kpzip/Stepper-Music/README.md

# Stepper-Music
Music with Stepper Motors!
