kpzip/Stepper-Music/models/axle_pointer/axle_pointer.FCStd

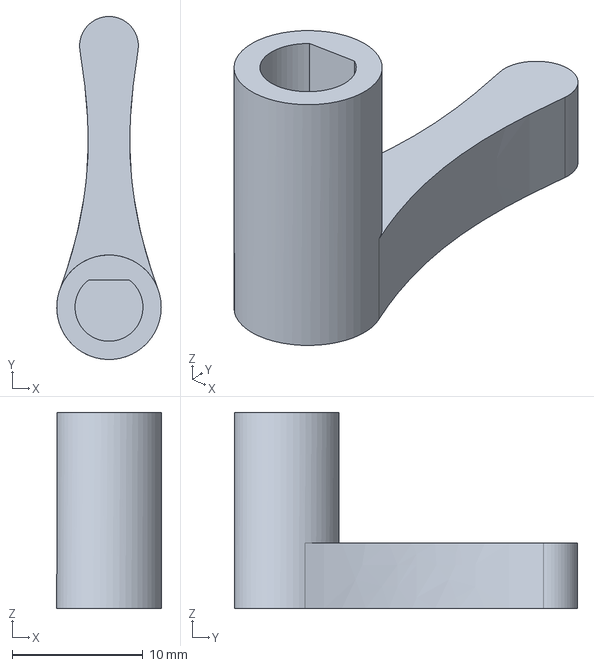
[picture p1: CAD file, 2026-04-19]
models/axle_pointer/axle_pointer.FCStd
8.00 x 26.2 x 15.0 mm
