kpzip/Stepper-Music/models/simple_4_stepper_enclosure/simple_4_stepper_enclosure.FCStd

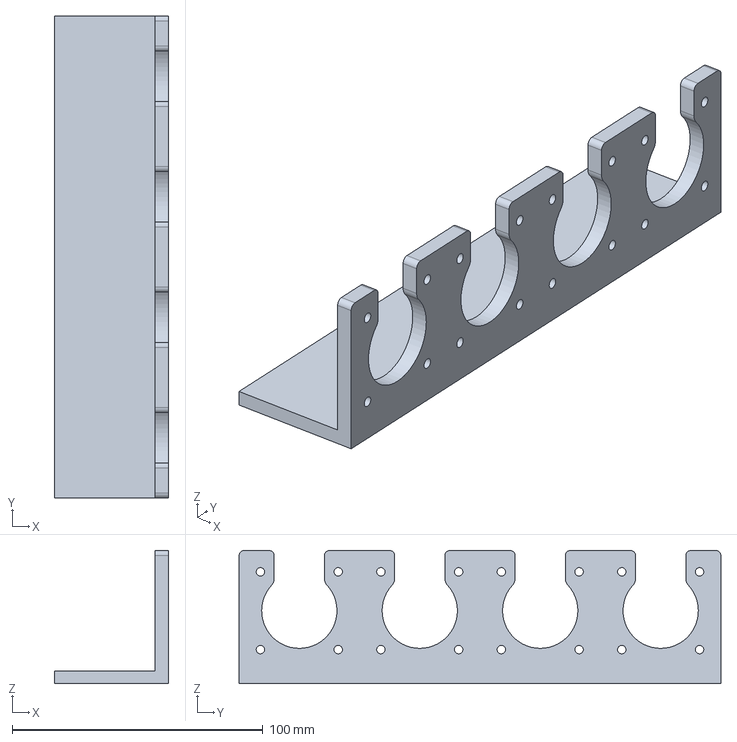
[picture p2: CAD file, 2026-04-19]
models/simple_4_stepper_enclosure/simple_4_stepper_enclosure.FCStd
45.5 x 192.0 x 53.0 mm
