kpzip/Stepper-Music/pcb/1.0/stepper_music.kicad_pcb

## KiCad design pcb/1.0/stepper_music.kicad_pcb (2026-04-06)

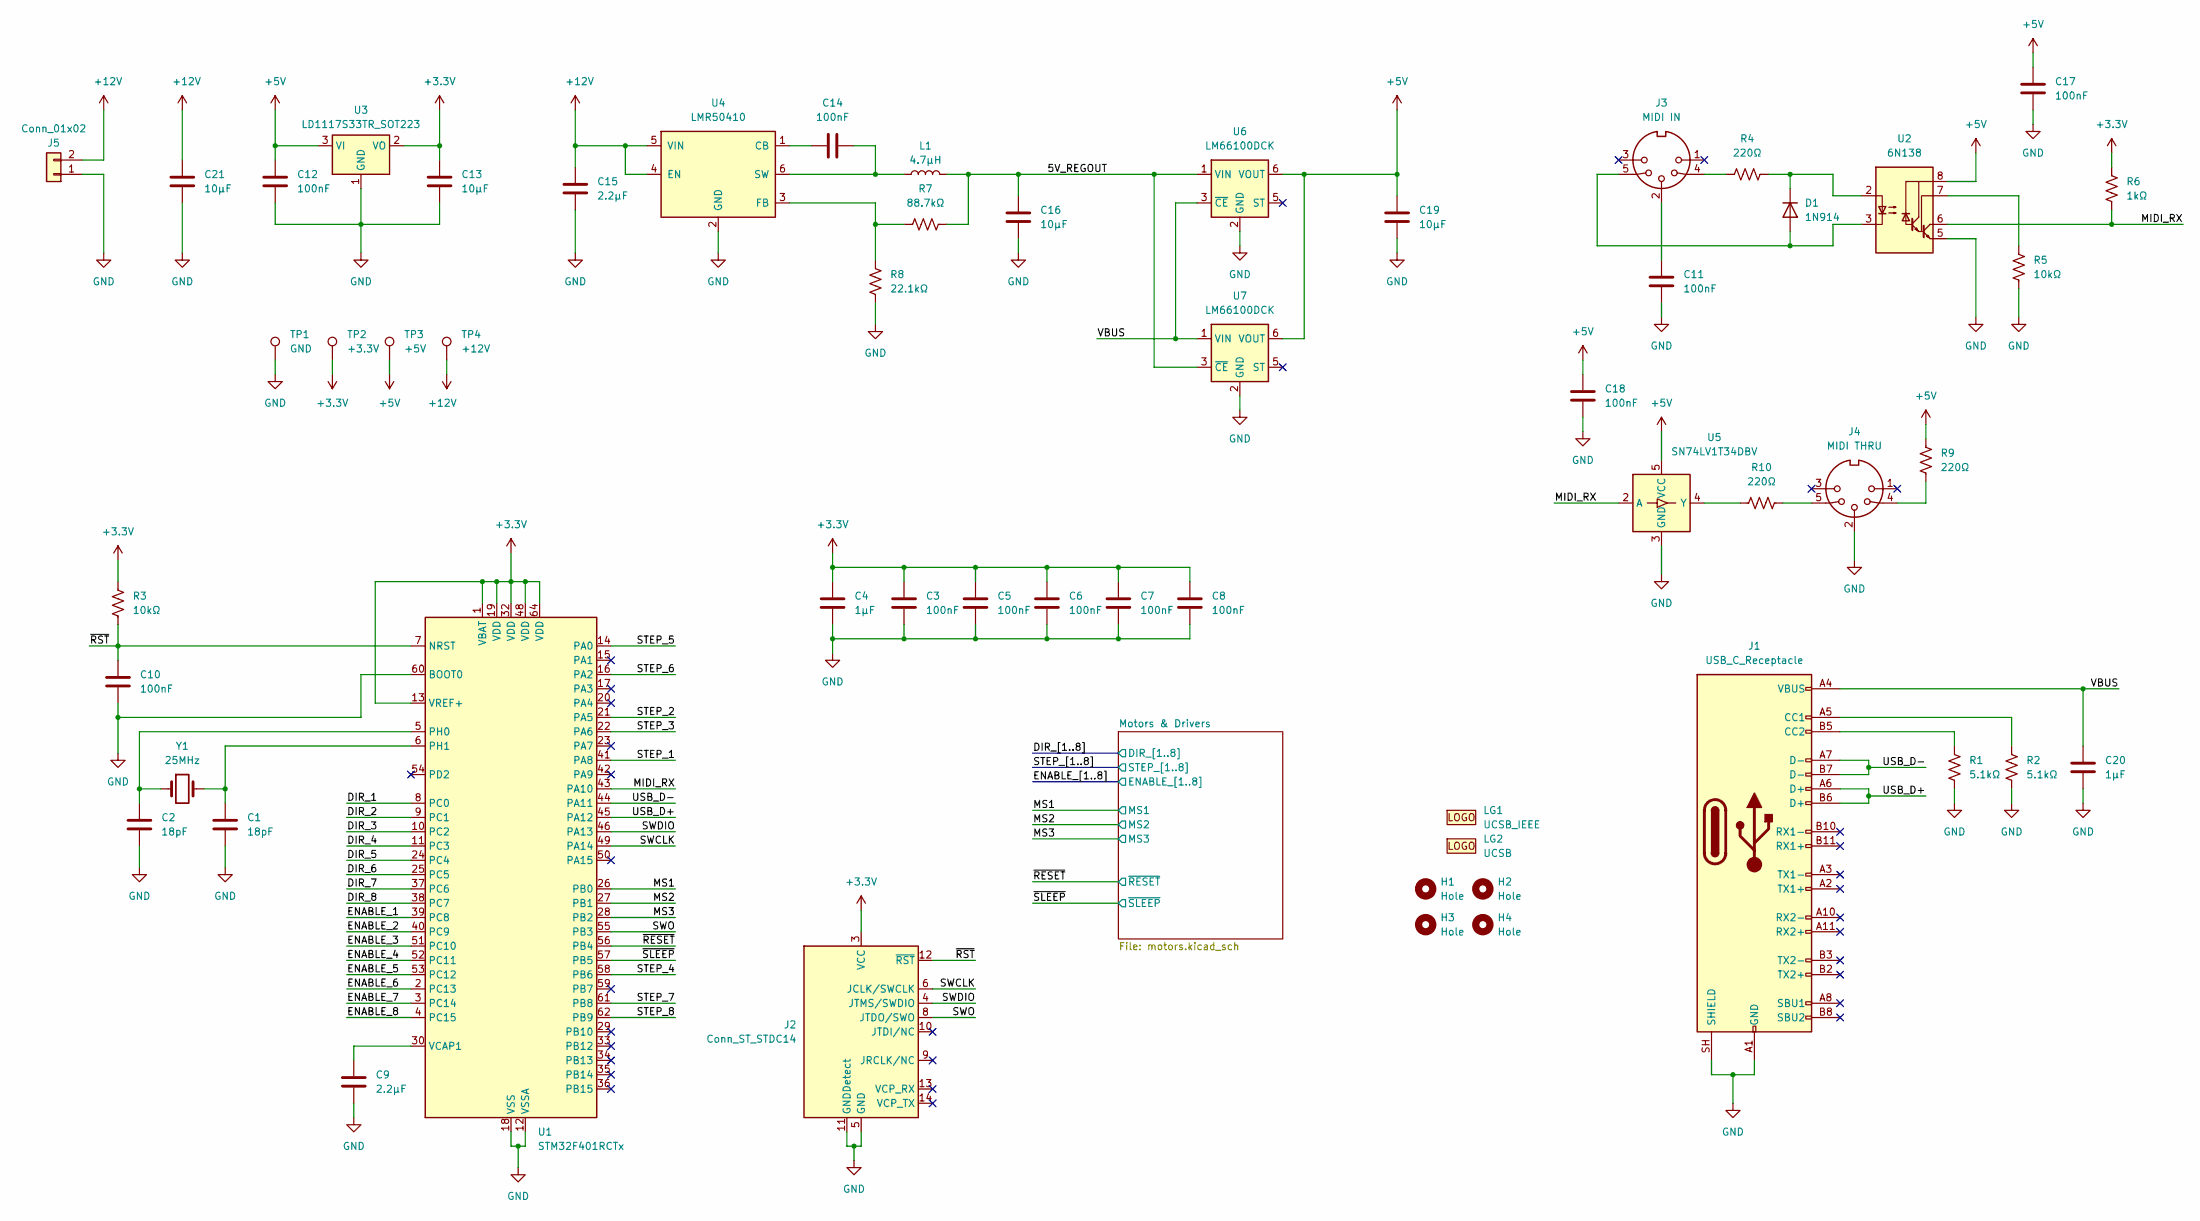
[picture p3: schematic stepper_music.kicad_sch]

Parts:
C1, C2: 18pF; C_0402_1005Metric; Manufacturer Part Number GJM1555C1H180GB01D
C3, C5, C6, C7, C8, C10, C11, C12, C14, C17, C18: 100nF; C_1206_3216Metric_Pad1.33x1.80mm_HandSolder; Manufacturer Part Number 1206B104K500CT
C4, C20: 1μF; C_1206_3216Metric_Pad1.33x1.80mm_HandSolder; Manufacturer Part Number CL31B105KAHNNNE
C9, C15: 2.2μF; C_1206_3216Metric_Pad1.33x1.80mm_HandSolder; Manufacturer Part Number UMK316BJ225KD-T
C13, C16, C19, C21: 10μF; C_1206_3216Metric_Pad1.33x1.80mm_HandSolder; Manufacturer Part Number 1276-1181-1-ND
D1: 1N914; D_SOD-523; Manufacturer Part Number 1N914BWT
H1, H2, H3, H4: Hole; MountingHole_3.2mm_M3_DIN965
J1: USB_C_Receptacle; USB_C_Receptacle_short; Manufacturer Part Number USB4056-03-A
J2: Conn_ST_STDC14; PinHeader_2x07_P1.27mm_Vertical_SMD; Manufacturer Part Number FTSH-107-01-L-DV-K
J3: MIDI IN; KYCON_KCDX-5S-N; Manufacturer Part Number KCDX-5S-N
J4: MIDI THRU; KYCON_KCDX-5S-N; Manufacturer Part Number KCDX-5S-N
J5: Conn_01x02; AMASS_XT60PW-M_1x02_P7.20mm_Horizontal; Manufacturer Part Number XT60PW-M30
L1: 4.7μH; L_1008_2520Metric_Pad1.43x2.20mm_HandSolder; Manufacturer Part Number DFE252012P-4R7M=P2
LG1: UCSB_IEEE; UCSB_IEEE_Logo
LG2: UCSB; UCSB_Medium
R1, R2: 5.1kΩ; R_1206_3216Metric_Pad1.30x1.75mm_HandSolder; Manufacturer Part Number RC1206FR-075K1L
R3, R5: 10kΩ; R_1206_3216Metric_Pad1.30x1.75mm_HandSolder; Manufacturer Part Number RMCF1206FT10K0
R4, R9, R10: 220Ω; R_1206_3216Metric_Pad1.30x1.75mm_HandSolder; Manufacturer Part Number RMCF1206FT220R
R6: 1kΩ; R_1206_3216Metric_Pad1.30x1.75mm_HandSolder; Manufacturer Part Number RC1206FR-071KL
R7: 88.7kΩ; R_1206_3216Metric_Pad1.30x1.75mm_HandSolder; Manufacturer Part Number RC1206FR-0788K7L
R8: 22.1kΩ; R_1206_3216Metric_Pad1.30x1.75mm_HandSolder; Manufacturer Part Number CRCW120622K1FKEAC
TP1: GND; TestPoint_Pad_D1.5mm
TP2: +3.3V; TestPoint_Pad_D1.5mm
TP3: +5V; TestPoint_Pad_D1.5mm
TP4: +12V; TestPoint_Pad_D1.5mm
U1: STM32F401RCTx; LQFP-64_10x10mm_P0.5mm; Manufacturer Part Number STM32F401RCT6
U2: 6N138; SOIC-8_3.9x4.9mm_P1.27mm; Manufacturer Part Number HCPL-0701
U3: LD1117S33TR_SOT223; SOT-223-3_TabPin2; Manufacturer Part Number LD1117S33TR
U4: LMR50410; SOT-23-6; Manufacturer Part Number 296-LMR50410Y5FQDBVRQ1CT-ND
U5: SN74LV1T34DBV; SOT-23-5; Manufacturer Part Number SN74LV1T34DBVR
U6, U7: LM66100DCK; SOT-363_SC-70-6; Manufacturer Part Number LM66100DCKR
Y1: 25MHz; Crystal_SMD_HC49-SD; Manufacturer Part Number ECS-250-18-5PX-F-TR

Connections:
+3.3V: C3.1, C4.1, C5.1, C6.1, C7.1, C8.1, C13.1, J2.3 (VCC), R3.1, R6.1, TP2.1 (1_1), U1.1 (VBAT), U1.13 (VREF+), U1.19 (VDD), U1.32 (VDD), U1.48 (VDD), U1.64 (VDD), U3.2 (VO); also elsewhere on the board
+5V: C12.1, C17.1, C18.1, C19.1, R9.2, TP3.1 (1_1), U2.8 (VCC), U3.3 (VI), U5.5 (VCC), U6.6 (VOUT), U7.6 (VOUT)
+12V: C15.1, C21.1, J5.2, TP4.1 (1_1), U4.4 (EN), U4.5 (VIN); also elsewhere on the board
/5V_REGOUT: C16.1, L1.2, R7.2, U6.1 (VIN), U7.3 (~CE)
/DIR_1: U1.8 (PC0); also elsewhere on the board
/DIR_2: U1.9 (PC1); also elsewhere on the board
/DIR_3: U1.10 (PC2); also elsewhere on the board
/DIR_4: U1.11 (PC3); also elsewhere on the board
/DIR_5: U1.24 (PC4); also elsewhere on the board
/DIR_6: U1.25 (PC5); also elsewhere on the board
/DIR_7: U1.37 (PC6); also elsewhere on the board
/DIR_8: U1.38 (PC7); also elsewhere on the board
/ENABLE_1: U1.39 (PC8); also elsewhere on the board
/ENABLE_2: U1.40 (PC9); also elsewhere on the board
/ENABLE_3: U1.51 (PC10); also elsewhere on the board
/ENABLE_4: U1.52 (PC11); also elsewhere on the board
/ENABLE_5: U1.53 (PC12); also elsewhere on the board
/ENABLE_6: U1.2 (PC13); also elsewhere on the board
/ENABLE_7: U1.3 (PC14); also elsewhere on the board
/ENABLE_8: U1.4 (PC15); also elsewhere on the board
/MIDI_RX: R6.2, U1.43 (PA10), U2.6 (VO2), U5.2 (A)
/MS1: U1.26 (PB0); also elsewhere on the board
/MS2: U1.27 (PB1); also elsewhere on the board
/MS3: U1.28 (PB2); also elsewhere on the board
/STEP_1: U1.41 (PA8); also elsewhere on the board
/STEP_2: U1.21 (PA5); also elsewhere on the board
/STEP_3: U1.22 (PA6); also elsewhere on the board
/STEP_4: U1.58 (PB6); also elsewhere on the board
/STEP_5: U1.14 (PA0); also elsewhere on the board
/STEP_6: U1.16 (PA2); also elsewhere on the board
/STEP_7: U1.61 (PB8); also elsewhere on the board
/STEP_8: U1.62 (PB9); also elsewhere on the board
/SWCLK: J2.6 (JCLK/SWCLK), U1.49 (PA14)
/SWDIO: J2.4 (JTMS/SWDIO), U1.46 (PA13)
/SWO: J2.8 (JTDO/SWO), U1.55 (PB3)
/USB_D+: J1.A6 (D+), J1.B6 (D+), U1.45 (PA12)
/USB_D-: J1.A7 (D-), J1.B7 (D-), U1.44 (PA11)
/VBUS: C20.1, J1.A4 (VBUS), J1.A9 (VBUS), J1.B4 (VBUS), J1.B9 (VBUS), U6.3 (~CE), U7.1 (VIN)
/~RESET: U1.56 (PB4); also elsewhere on the board
/~RST: C10.1, J2.12 (~RST), R3.2, U1.7 (NRST)
/~SLEEP: U1.57 (PB5); also elsewhere on the board
GND: C1.2, C2.2, C3.2, C4.2, C5.2, C6.2, C7.2, C8.2, C9.2, C10.2, C11.2, C12.2, C13.2, C15.2, C16.2, C17.2, C18.2, C19.2, C20.2, C21.2, J1.A1 (GND), J1.A12 (GND), J1.B1 (GND), J1.B12 (GND), J1.SH (SHIELD), J2.5 (GND), J2.7 (GND), J2.11 (GNDDetect), J4.2, J5.1, R1.2, R2.2, R5.2, R8.2, TP1.1 (1_1), U1.12 (VSSA), U1.18 (VSS), U1.31 (VSS), U1.47 (VSS), U1.60 (BOOT0), U1.63 (VSS), U2.5 (GND), U3.1 (GND), U4.2 (GND), U5.3 (GND), U6.2 (GND), U7.2 (GND); also elsewhere on the board
unnamed: C11.1, J3.2
unnamed: D1.2 (A), J3.5, U2.3 (C2)
unnamed: D1.1 (K), R4.2, U2.2 (C1)
unnamed: J1.A5 (CC1), R2.1
unnamed: J1.B5 (CC2), R1.1
unnamed: J3.4, R4.1
unnamed: J4.4, R9.1
unnamed: J4.5, R10.1
unnamed: C2.1, U1.5 (PH0), Y1.1
unnamed: C1.1, U1.6 (PH1), Y1.2
unnamed: C9.1, U1.30 (VCAP1)
unnamed: R5.1, U2.7 (VO1)
unnamed: C14.1, U4.1 (CB)
unnamed: R7.1, R8.1, U4.3 (FB)
unnamed: C14.2, L1.1, U4.6 (SW)
unnamed: R10.2, U5.4 (Y)

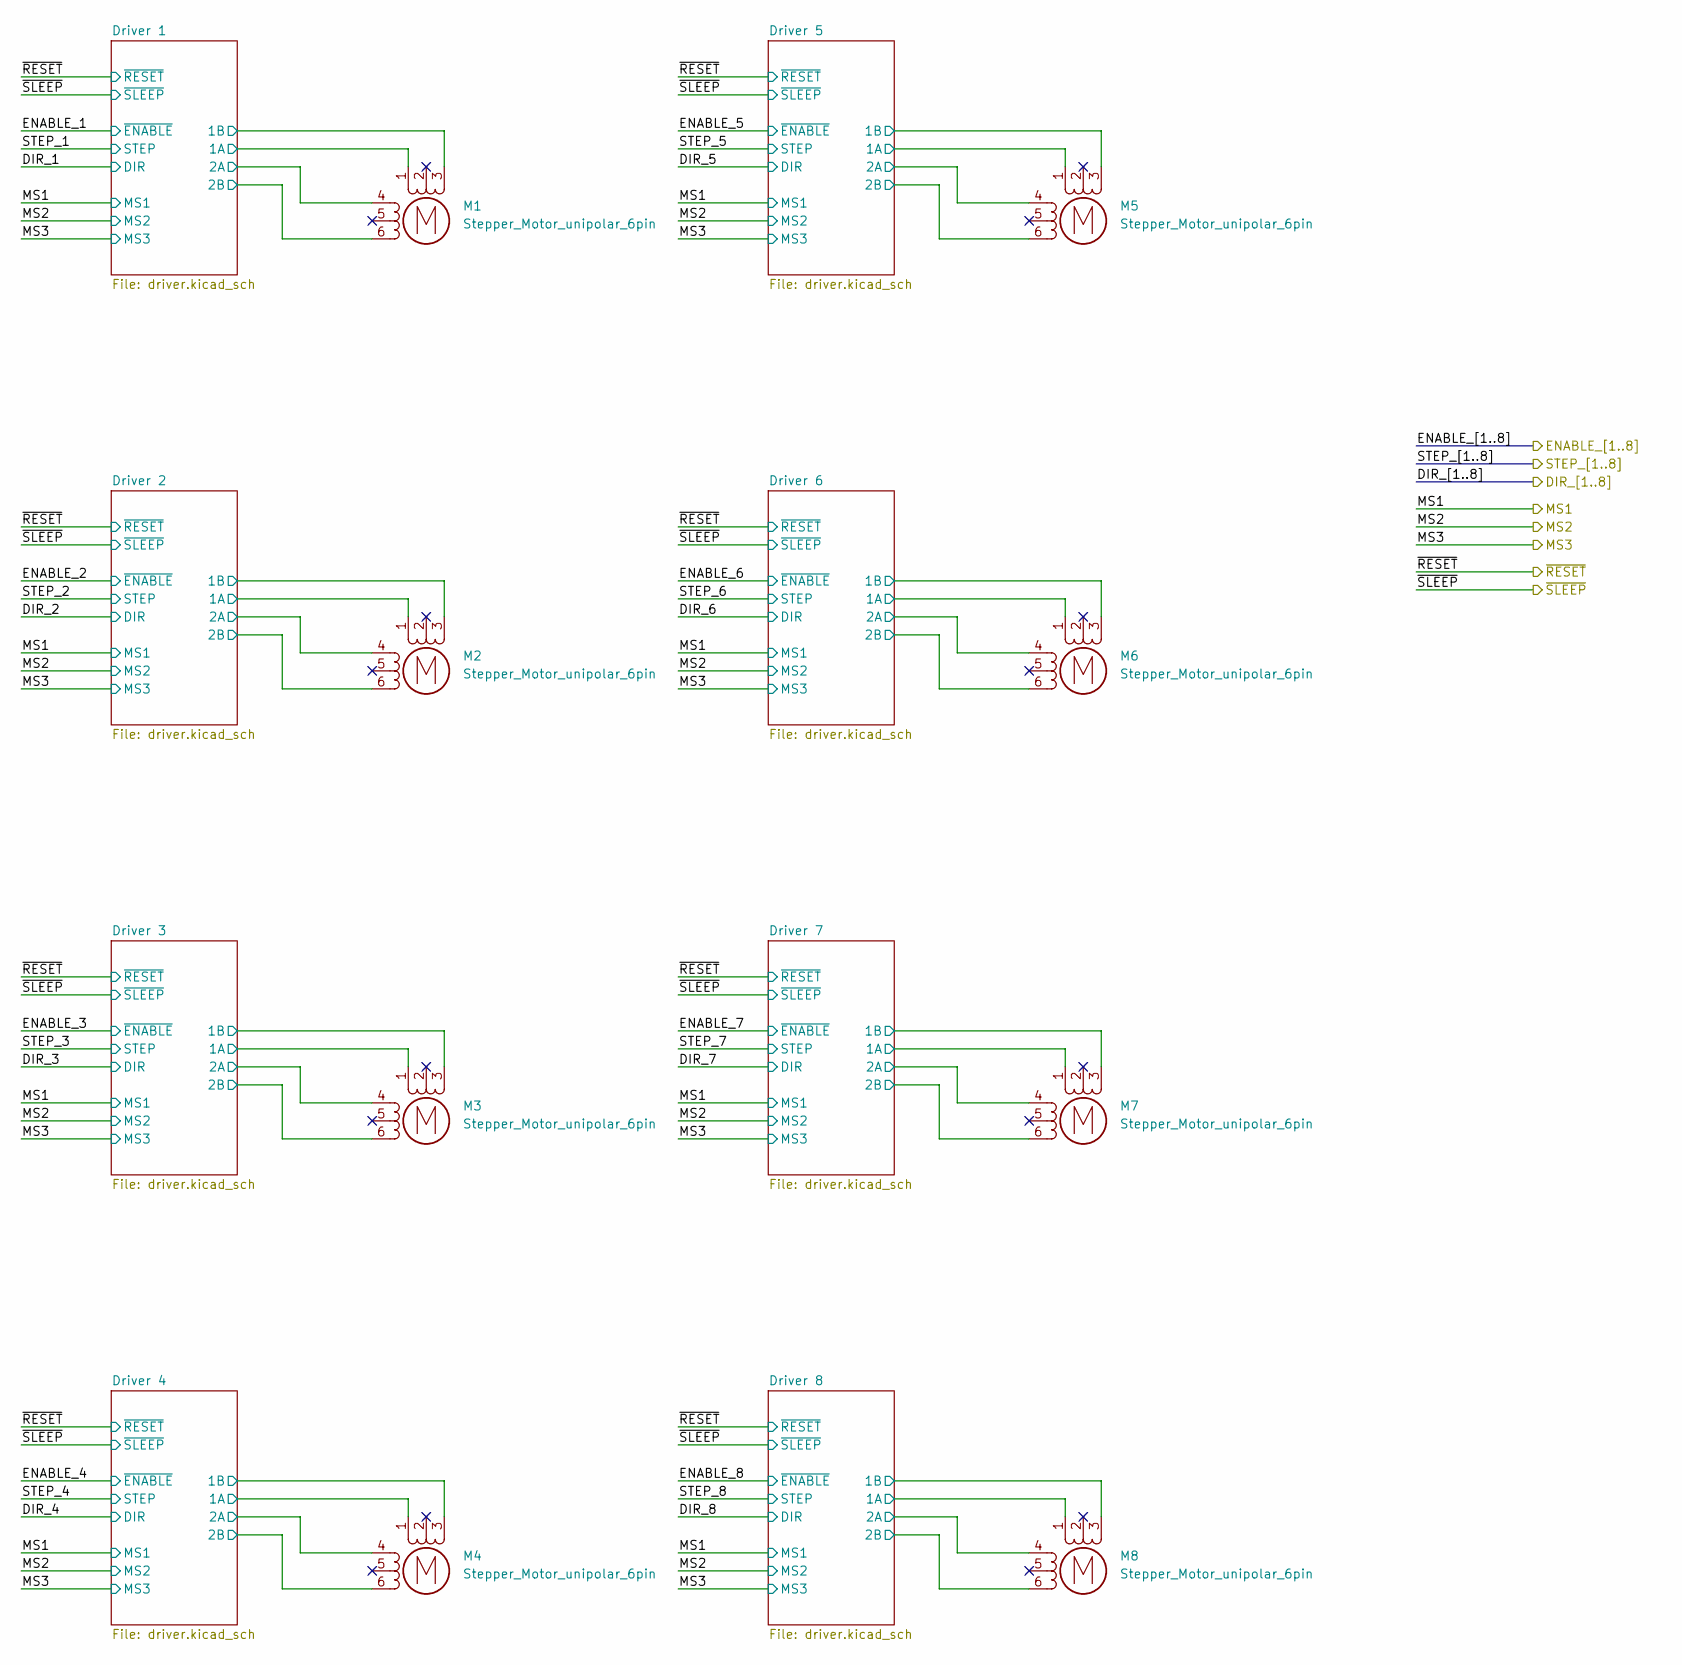
[picture p4: schematic motors.kicad_sch]

Parts:
M1, M2, M3, M4, M5, M6, M7, M8: Stepper_Motor_unipolar_6pin; JST_PH_B6B-PH-K_1x06_P2.00mm_Vertical; Manufacturer Part Number B6B-PH-K-S

Connections:
/Motors & Drivers/Driver 1/1A: M1.1; also elsewhere on the board
/Motors & Drivers/Driver 1/1B: M1.3 (-_3); also elsewhere on the board
/Motors & Drivers/Driver 1/2A: M1.4; also elsewhere on the board
/Motors & Drivers/Driver 1/2B: M1.6; also elsewhere on the board
/Motors & Drivers/Driver 2/1A: M2.1; also elsewhere on the board
/Motors & Drivers/Driver 2/1B: M2.3 (-_3); also elsewhere on the board
/Motors & Drivers/Driver 2/2A: M2.4; also elsewhere on the board
/Motors & Drivers/Driver 2/2B: M2.6; also elsewhere on the board
/Motors & Drivers/Driver 3/1A: M3.1; also elsewhere on the board
/Motors & Drivers/Driver 3/1B: M3.3 (-_3); also elsewhere on the board
/Motors & Drivers/Driver 3/2A: M3.4; also elsewhere on the board
/Motors & Drivers/Driver 3/2B: M3.6; also elsewhere on the board
/Motors & Drivers/Driver 4/1A: M4.1; also elsewhere on the board
/Motors & Drivers/Driver 4/1B: M4.3 (-_3); also elsewhere on the board
/Motors & Drivers/Driver 4/2A: M4.4; also elsewhere on the board
/Motors & Drivers/Driver 4/2B: M4.6; also elsewhere on the board
/Motors & Drivers/Driver 5/1A: M5.1; also elsewhere on the board
/Motors & Drivers/Driver 5/1B: M5.3 (-_3); also elsewhere on the board
/Motors & Drivers/Driver 5/2A: M5.4; also elsewhere on the board
/Motors & Drivers/Driver 5/2B: M5.6; also elsewhere on the board
/Motors & Drivers/Driver 6/1A: M6.1; also elsewhere on the board
/Motors & Drivers/Driver 6/1B: M6.3 (-_3); also elsewhere on the board
/Motors & Drivers/Driver 6/2A: M6.4; also elsewhere on the board
/Motors & Drivers/Driver 6/2B: M6.6; also elsewhere on the board
/Motors & Drivers/Driver 7/1A: M7.1; also elsewhere on the board
/Motors & Drivers/Driver 7/1B: M7.3 (-_3); also elsewhere on the board
/Motors & Drivers/Driver 7/2A: M7.4; also elsewhere on the board
/Motors & Drivers/Driver 7/2B: M7.6; also elsewhere on the board
/Motors & Drivers/Driver 8/1A: M8.1; also elsewhere on the board
/Motors & Drivers/Driver 8/1B: M8.3 (-_3); also elsewhere on the board
/Motors & Drivers/Driver 8/2A: M8.4; also elsewhere on the board
/Motors & Drivers/Driver 8/2B: M8.6; also elsewhere on the board

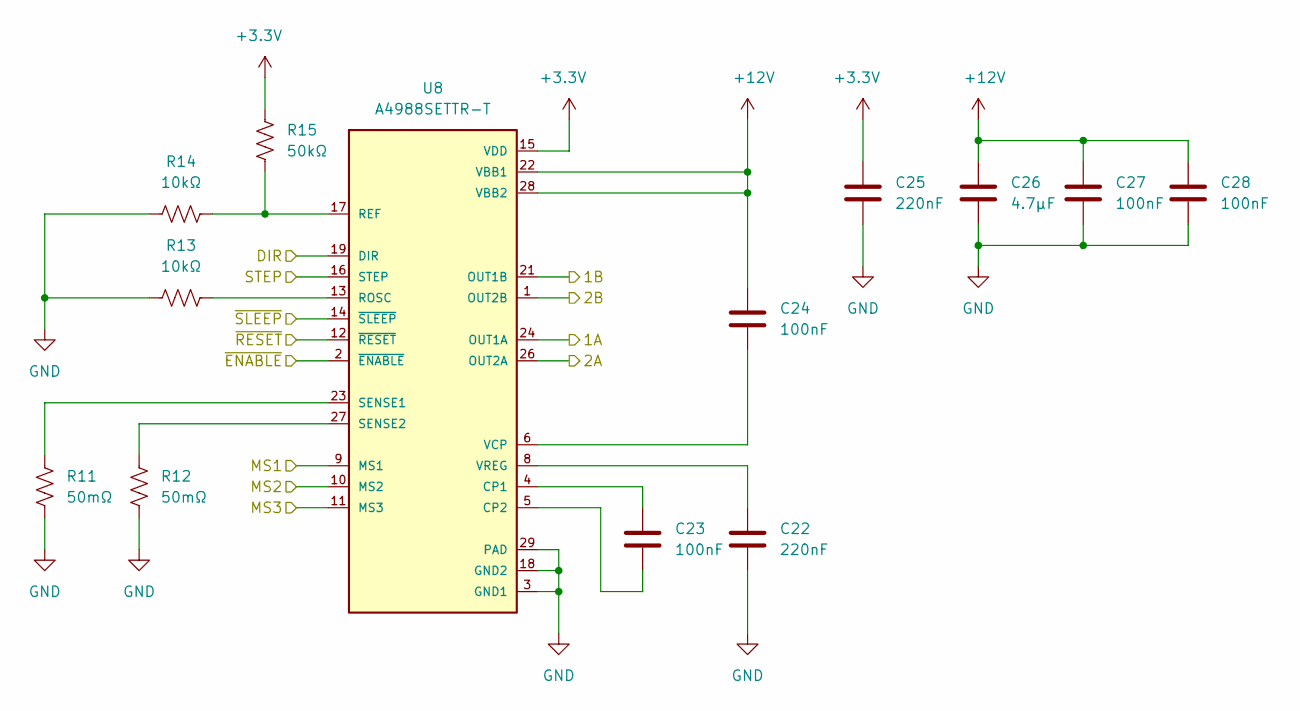
[picture p5: schematic driver.kicad_sch]

Parts:
C22, C25: 220nF; C_1206_3216Metric_Pad1.33x1.80mm_HandSolder; Manufacturer Part Number C1206C224K5RACTU
C23, C24, C27, C28: 100nF; C_1206_3216Metric_Pad1.33x1.80mm_HandSolder; Manufacturer Part Number 1206B104K500CT
C26: 4.7μF; C_1206_3216Metric_Pad1.33x1.80mm_HandSolder; Manufacturer Part Number CL31B475KAHNNNE
R11, R12: 50mΩ; R_1206_3216Metric_Pad1.30x1.75mm_HandSolder; Manufacturer Part Number CSR1206FT50L0
R13, R14: 10kΩ; R_1206_3216Metric_Pad1.30x1.75mm_HandSolder; Manufacturer Part Number RMCF1206FT10K0
R15: 50kΩ; R_1206_3216Metric_Pad1.30x1.75mm_HandSolder; Manufacturer Part Number RT1206BRD0750KL
U8: A4988SETTR-T; VQFN-28-1EP_5x5mm_P0.5mm_EP3.25x3.25mm_ThermalVias; Manufacturer Part Number A4988SETTR-T

Connections:
+3.3V: C25.1, R15.2, U8.15 (VDD); also elsewhere on the board
+12V: C24.1, C26.1, C27.1, C28.1, U8.22 (VBB1), U8.28 (VBB2); also elsewhere on the board
/DIR_1: U8.19 (DIR); also elsewhere on the board
/ENABLE_1: U8.2 (~ENABLE); also elsewhere on the board
/MS1: U8.9 (MS1); also elsewhere on the board
/MS2: U8.10 (MS2); also elsewhere on the board
/MS3: U8.11 (MS3); also elsewhere on the board
/Motors & Drivers/Driver 1/1A: U8.24 (OUT1A); also elsewhere on the board
/Motors & Drivers/Driver 1/1B: U8.21 (OUT1B); also elsewhere on the board
/Motors & Drivers/Driver 1/2A: U8.26 (OUT2A); also elsewhere on the board
/Motors & Drivers/Driver 1/2B: U8.1 (OUT2B); also elsewhere on the board
/STEP_1: U8.16 (STEP); also elsewhere on the board
/~RESET: U8.12 (~RESET); also elsewhere on the board
/~SLEEP: U8.14 (~SLEEP); also elsewhere on the board
GND: C22.2, C25.2, C26.2, C27.2, C28.2, R11.2, R12.2, R13.1, R14.1, U8.3 (GND1), U8.18 (GND2), U8.29 (PAD); also elsewhere on the board
unnamed: C23.1, U8.4 (CP1)
unnamed: C23.2, U8.5 (CP2)
unnamed: R14.2, R15.1, U8.17 (REF)
unnamed: R13.2, U8.13 (ROSC)
unnamed: R11.1, U8.23 (SENSE1)
unnamed: R12.1, U8.27 (SENSE2)
unnamed: C24.2, U8.6 (VCP)
unnamed: C22.1, U8.8 (VREG)

Parts of its further copies:
C29, C30, C34, C35, C36, C37, C41, C42, C43, C44, C48, C49, C50, C51, C55, C56, C57, C58, C62, C63, C64, C65, C69, C70, C71, C72, C76, C77: 100nF; C_1206_3216Metric_Pad1.33x1.80mm_HandSolder; Manufacturer Part Number 1206B104K500CT
C31, C32, C38, C39, C45, C46, C52, C53, C59, C60, C66, C67, C73, C74: 220nF; C_1206_3216Metric_Pad1.33x1.80mm_HandSolder; Manufacturer Part Number C1206C224K5RACTU
C33, C40, C47, C54, C61, C68, C75: 4.7μF; C_1206_3216Metric_Pad1.33x1.80mm_HandSolder; Manufacturer Part Number CL31B475KAHNNNE
R16, R17, R21, R22, R26, R27, R31, R32, R36, R37, R41, R42, R46, R47: 50mΩ; R_1206_3216Metric_Pad1.30x1.75mm_HandSolder; Manufacturer Part Number CSR1206FT50L0
R18, R19, R23, R24, R28, R29, R33, R34, R38, R39, R43, R44, R48, R49: 10kΩ; R_1206_3216Metric_Pad1.30x1.75mm_HandSolder; Manufacturer Part Number RMCF1206FT10K0
R20, R25, R30, R35, R40, R45, R50: 50kΩ; R_1206_3216Metric_Pad1.30x1.75mm_HandSolder; Manufacturer Part Number RT1206BRD0750KL
U9, U10, U11, U12, U13, U14, U15: A4988SETTR-T; VQFN-28-1EP_5x5mm_P0.5mm_EP3.25x3.25mm_ThermalVias; Manufacturer Part Number A4988SETTR-T

Connections of its further copies:
+3.3V: C32.1, C39.1, C46.1, C53.1, C60.1, C67.1, C74.1, R20.2, R25.2, R30.2, R35.2, R40.2, R45.2, R50.2, U9.15 (VDD), U10.15 (VDD), U11.15 (VDD), U12.15 (VDD), U13.15 (VDD), U14.15 (VDD), U15.15 (VDD); also elsewhere on the board
+12V: C30.1, C33.1, C34.1, C35.1, C37.1, C40.1, C41.1, C42.1, C44.1, C47.1, C48.1, C49.1, C51.1, C54.1, C55.1, C56.1, C58.1, C61.1, C62.1, C63.1, C65.1, C68.1, C69.1, C70.1, C72.1, C75.1, C76.1, C77.1, U9.22 (VBB1), U9.28 (VBB2), U10.22 (VBB1), U10.28 (VBB2), U11.22 (VBB1), U11.28 (VBB2), U12.22 (VBB1), U12.28 (VBB2), U13.22 (VBB1), U13.28 (VBB2), U14.22 (VBB1), U14.28 (VBB2), U15.22 (VBB1), U15.28 (VBB2); also elsewhere on the board
/DIR_2: U9.19 (DIR); also elsewhere on the board
/DIR_3: U10.19 (DIR); also elsewhere on the board
/DIR_4: U11.19 (DIR); also elsewhere on the board
/DIR_5: U12.19 (DIR); also elsewhere on the board
/DIR_6: U13.19 (DIR); also elsewhere on the board
/DIR_7: U14.19 (DIR); also elsewhere on the board
/DIR_8: U15.19 (DIR); also elsewhere on the board
/ENABLE_2: U9.2 (~ENABLE); also elsewhere on the board
/ENABLE_3: U10.2 (~ENABLE); also elsewhere on the board
/ENABLE_4: U11.2 (~ENABLE); also elsewhere on the board
/ENABLE_5: U12.2 (~ENABLE); also elsewhere on the board
/ENABLE_6: U13.2 (~ENABLE); also elsewhere on the board
/ENABLE_7: U14.2 (~ENABLE); also elsewhere on the board
/ENABLE_8: U15.2 (~ENABLE); also elsewhere on the board
/MS1: U9.9 (MS1), U10.9 (MS1), U11.9 (MS1), U12.9 (MS1), U13.9 (MS1), U14.9 (MS1), U15.9 (MS1); also elsewhere on the board
/MS2: U9.10 (MS2), U10.10 (MS2), U11.10 (MS2), U12.10 (MS2), U13.10 (MS2), U14.10 (MS2), U15.10 (MS2); also elsewhere on the board
/MS3: U9.11 (MS3), U10.11 (MS3), U11.11 (MS3), U12.11 (MS3), U13.11 (MS3), U14.11 (MS3), U15.11 (MS3); also elsewhere on the board
/Motors & Drivers/Driver 2/1A: U9.24 (OUT1A); also elsewhere on the board
/Motors & Drivers/Driver 2/1B: U9.21 (OUT1B); also elsewhere on the board
/Motors & Drivers/Driver 2/2A: U9.26 (OUT2A); also elsewhere on the board
/Motors & Drivers/Driver 2/2B: U9.1 (OUT2B); also elsewhere on the board
/Motors & Drivers/Driver 3/1A: U10.24 (OUT1A); also elsewhere on the board
/Motors & Drivers/Driver 3/1B: U10.21 (OUT1B); also elsewhere on the board
/Motors & Drivers/Driver 3/2A: U10.26 (OUT2A); also elsewhere on the board
/Motors & Drivers/Driver 3/2B: U10.1 (OUT2B); also elsewhere on the board
/Motors & Drivers/Driver 4/1A: U11.24 (OUT1A); also elsewhere on the board
/Motors & Drivers/Driver 4/1B: U11.21 (OUT1B); also elsewhere on the board
/Motors & Drivers/Driver 4/2A: U11.26 (OUT2A); also elsewhere on the board
/Motors & Drivers/Driver 4/2B: U11.1 (OUT2B); also elsewhere on the board
/Motors & Drivers/Driver 5/1A: U12.24 (OUT1A); also elsewhere on the board
/Motors & Drivers/Driver 5/1B: U12.21 (OUT1B); also elsewhere on the board
/Motors & Drivers/Driver 5/2A: U12.26 (OUT2A); also elsewhere on the board
/Motors & Drivers/Driver 5/2B: U12.1 (OUT2B); also elsewhere on the board
/Motors & Drivers/Driver 6/1A: U13.24 (OUT1A); also elsewhere on the board
/Motors & Drivers/Driver 6/1B: U13.21 (OUT1B); also elsewhere on the board
/Motors & Drivers/Driver 6/2A: U13.26 (OUT2A); also elsewhere on the board
/Motors & Drivers/Driver 6/2B: U13.1 (OUT2B); also elsewhere on the board
/Motors & Drivers/Driver 7/1A: U14.24 (OUT1A); also elsewhere on the board
/Motors & Drivers/Driver 7/1B: U14.21 (OUT1B); also elsewhere on the board
/Motors & Drivers/Driver 7/2A: U14.26 (OUT2A); also elsewhere on the board
/Motors & Drivers/Driver 7/2B: U14.1 (OUT2B); also elsewhere on the board
/Motors & Drivers/Driver 8/1A: U15.24 (OUT1A); also elsewhere on the board
/Motors & Drivers/Driver 8/1B: U15.21 (OUT1B); also elsewhere on the board
/Motors & Drivers/Driver 8/2A: U15.26 (OUT2A); also elsewhere on the board
/Motors & Drivers/Driver 8/2B: U15.1 (OUT2B); also elsewhere on the board
/STEP_2: U9.16 (STEP); also elsewhere on the board
/STEP_3: U10.16 (STEP); also elsewhere on the board
/STEP_4: U11.16 (STEP); also elsewhere on the board
/STEP_5: U12.16 (STEP); also elsewhere on the board
/STEP_6: U13.16 (STEP); also elsewhere on the board
/STEP_7: U14.16 (STEP); also elsewhere on the board
/STEP_8: U15.16 (STEP); also elsewhere on the board
/~RESET: U9.12 (~RESET), U10.12 (~RESET), U11.12 (~RESET), U12.12 (~RESET), U13.12 (~RESET), U14.12 (~RESET), U15.12 (~RESET); also elsewhere on the board
/~SLEEP: U9.14 (~SLEEP), U10.14 (~SLEEP), U11.14 (~SLEEP), U12.14 (~SLEEP), U13.14 (~SLEEP), U14.14 (~SLEEP), U15.14 (~SLEEP); also elsewhere on the board
GND: C31.2, C32.2, C33.2, C34.2, C35.2, C38.2, C39.2, C40.2, C41.2, C42.2, C45.2, C46.2, C47.2, C48.2, C49.2, C52.2, C53.2, C54.2, C55.2, C56.2, C59.2, C60.2, C61.2, C62.2, C63.2, C66.2, C67.2, C68.2, C69.2, C70.2, C73.2, C74.2, C75.2, C76.2, C77.2, R16.2, R17.2, R18.1, R19.1, R21.2, R22.2, R23.1, R24.1, R26.2, R27.2, R28.1, R29.1, R31.2, R32.2, R33.1, R34.1, R36.2, R37.2, R38.1, R39.1, R41.2, R42.2, R43.1, R44.1, R46.2, R47.2, R48.1, R49.1, U9.3 (GND1), U9.18 (GND2), U9.29 (PAD), U10.3 (GND1), U10.18 (GND2), U10.29 (PAD), U11.3 (GND1), U11.18 (GND2), U11.29 (PAD), U12.3 (GND1), U12.18 (GND2), U12.29 (PAD), U13.3 (GND1), U13.18 (GND2), U13.29 (PAD), U14.3 (GND1), U14.18 (GND2), U14.29 (PAD), U15.3 (GND1), U15.18 (GND2), U15.29 (PAD); also elsewhere on the board
unnamed: C29.1, U9.4 (CP1)
unnamed: C29.2, U9.5 (CP2)
unnamed: R18.2, R20.1, U9.17 (REF)
unnamed: R19.2, U9.13 (ROSC)
unnamed: R16.1, U9.23 (SENSE1)
unnamed: R17.1, U9.27 (SENSE2)
unnamed: C30.2, U9.6 (VCP)
unnamed: C31.1, U9.8 (VREG)
unnamed: C36.1, U10.4 (CP1)
unnamed: C36.2, U10.5 (CP2)
unnamed: R23.2, R25.1, U10.17 (REF)
unnamed: R24.2, U10.13 (ROSC)
unnamed: R21.1, U10.23 (SENSE1)
unnamed: R22.1, U10.27 (SENSE2)
unnamed: C37.2, U10.6 (VCP)
unnamed: C38.1, U10.8 (VREG)
unnamed: C43.1, U11.4 (CP1)
unnamed: C43.2, U11.5 (CP2)
unnamed: R28.2, R30.1, U11.17 (REF)
unnamed: R29.2, U11.13 (ROSC)
unnamed: R26.1, U11.23 (SENSE1)
unnamed: R27.1, U11.27 (SENSE2)
unnamed: C44.2, U11.6 (VCP)
unnamed: C45.1, U11.8 (VREG)
unnamed: C50.1, U12.4 (CP1)
unnamed: C50.2, U12.5 (CP2)
unnamed: R33.2, R35.1, U12.17 (REF)
unnamed: R34.2, U12.13 (ROSC)
unnamed: R31.1, U12.23 (SENSE1)
unnamed: R32.1, U12.27 (SENSE2)
unnamed: C51.2, U12.6 (VCP)
unnamed: C52.1, U12.8 (VREG)
unnamed: C57.1, U13.4 (CP1)
unnamed: C57.2, U13.5 (CP2)
unnamed: R38.2, R40.1, U13.17 (REF)
unnamed: R39.2, U13.13 (ROSC)
unnamed: R36.1, U13.23 (SENSE1)
unnamed: R37.1, U13.27 (SENSE2)
unnamed: C58.2, U13.6 (VCP)
unnamed: C59.1, U13.8 (VREG)
unnamed: C64.1, U14.4 (CP1)
unnamed: C64.2, U14.5 (CP2)
unnamed: R43.2, R45.1, U14.17 (REF)
unnamed: R44.2, U14.13 (ROSC)
unnamed: R41.1, U14.23 (SENSE1)
unnamed: R42.1, U14.27 (SENSE2)
unnamed: C65.2, U14.6 (VCP)
unnamed: C66.1, U14.8 (VREG)
unnamed: C71.1, U15.4 (CP1)
unnamed: C71.2, U15.5 (CP2)
unnamed: R48.2, R50.1, U15.17 (REF)
unnamed: R49.2, U15.13 (ROSC)
unnamed: R46.1, U15.23 (SENSE1)
unnamed: R47.1, U15.27 (SENSE2)
unnamed: C72.2, U15.6 (VCP)
unnamed: C73.1, U15.8 (VREG)

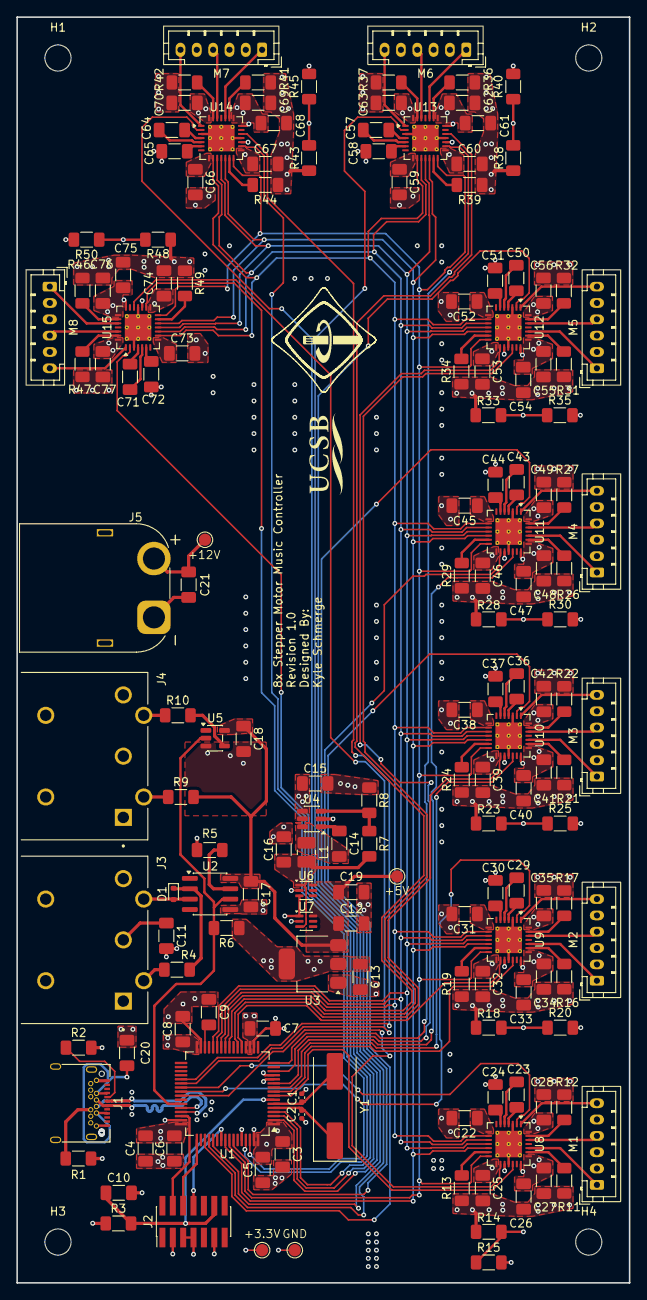
[picture p6: board stepper_music.kicad_pcb from above]

Board: 4 copper layers, 75.0 x 155.0 mm, 168 parts (0 on the bottom side), 154 nets.
