kpzip/Stepper-Music/firmware/stepper-music.ioc

Mcu.UserName=STM32F401RCTx
PA0-WKUP.Signal=S_TIM5_CH1
PA10.Signal=USART1_RX
PA11.Signal=USB_OTG_FS_DM
PA12.Signal=USB_OTG_FS_DP
PA2.Signal=S_TIM9_CH1
PA5.Signal=S_TIM2_CH1_ETR
PA6.Signal=S_TIM3_CH1
PA8.Signal=S_TIM1_CH1
PA9.Signal=USART1_TX
PB0.GPIO_Label=MS1
PB0.Signal=GPIO_Output
PB1.GPIO_Label=MS2
PB1.Signal=GPIO_Output
PB2.GPIO_Label=MS3
PB2.Signal=GPIO_Output
PB4.GPIO_Label=RESET
PB4.Signal=GPIO_Output
PB5.GPIO_Label=SLEEP
PB5.Signal=GPIO_Output
PB6.Signal=S_TIM4_CH1
PB8.Signal=S_TIM10_CH1
PB9.Signal=S_TIM11_CH1
PC0.GPIO_Label=DIR_1
PC0.Signal=GPIO_Output
PC1.GPIO_Label=DIR_2
PC1.Signal=GPIO_Output
PC10.GPIO_Label=ENABLE_3
PC10.Signal=GPIO_Output
PC11.GPIO_Label=ENABLE_4
PC11.Signal=GPIO_Output
PC12.GPIO_Label=ENABLE_5
PC12.Signal=GPIO_Output
PC13-ANTI_TAMP.GPIO_Label=ENABLE_6
PC13-ANTI_TAMP.Signal=GPIO_Output
PC14-OSC32_IN.GPIO_Label=ENABLE_7
PC14-OSC32_IN.Signal=GPIO_Output
PC15-OSC32_OUT.GPIO_Label=ENABLE_8
PC15-OSC32_OUT.Signal=GPIO_Output
PC2.GPIO_Label=DIR_3
PC2.Signal=GPIO_Output
PC3.GPIO_Label=DIR_4
PC3.Signal=GPIO_Output
PC4.GPIO_Label=DIR_5
PC4.Signal=GPIO_Output
PC5.GPIO_Label=DIR_6
PC5.Signal=GPIO_Output
PC6.GPIO_Label=DIR_7
PC6.Signal=GPIO_Output
PC7.GPIO_Label=DIR_8
PC7.Signal=GPIO_Output
PC8.GPIO_Label=ENABLE_1
PC8.Signal=GPIO_Output
PC9.GPIO_Label=ENABLE_2
PC9.Signal=GPIO_Output
