kpzip/Stepper-Music/firmware/Core/Inc/midi.h

/*
 * midi.h
 *
 *  Created on: Apr 17, 2026
 *      Author: kyle
 */

#ifndef INC_MIDI_H_
#define INC_MIDI_H_

#include "stm32f4xx_hal.h"

void setup();

void loop();

void enable_sleep();
void disable_sleep();

#endif /* INC_MIDI_H_ */
